rafaelmartins/octokeyz/README.md

# octokeyz

A USB macropad you program with Go.

For documentation please visit: https://octokeyz.rgm.io/

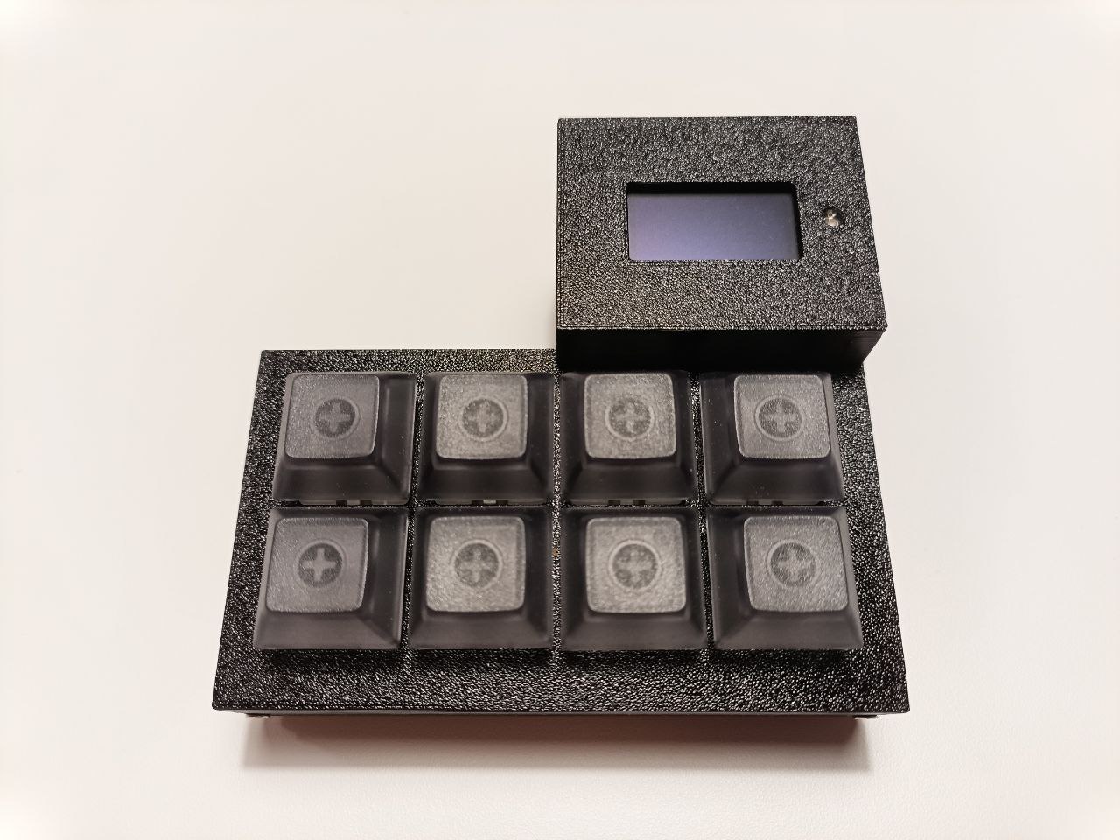
[picture p1: share/images/octokeyz-mega/front.jpg]
octokeyz-mega, assembled
