rafaelmartins/octokeyz/share/images/octokeyz-mega/side.jpg

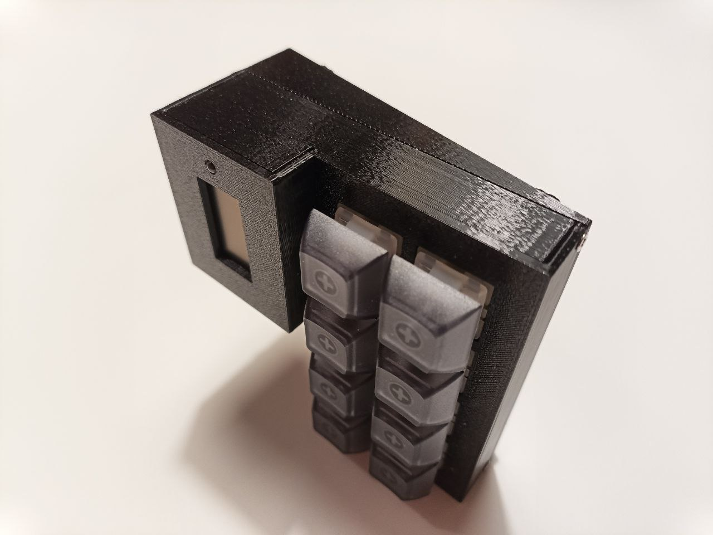
share/images/octokeyz-mega/side.jpg
