rafaelmartins/octokeyz/share/images/octokeyz-mega/top.jpg

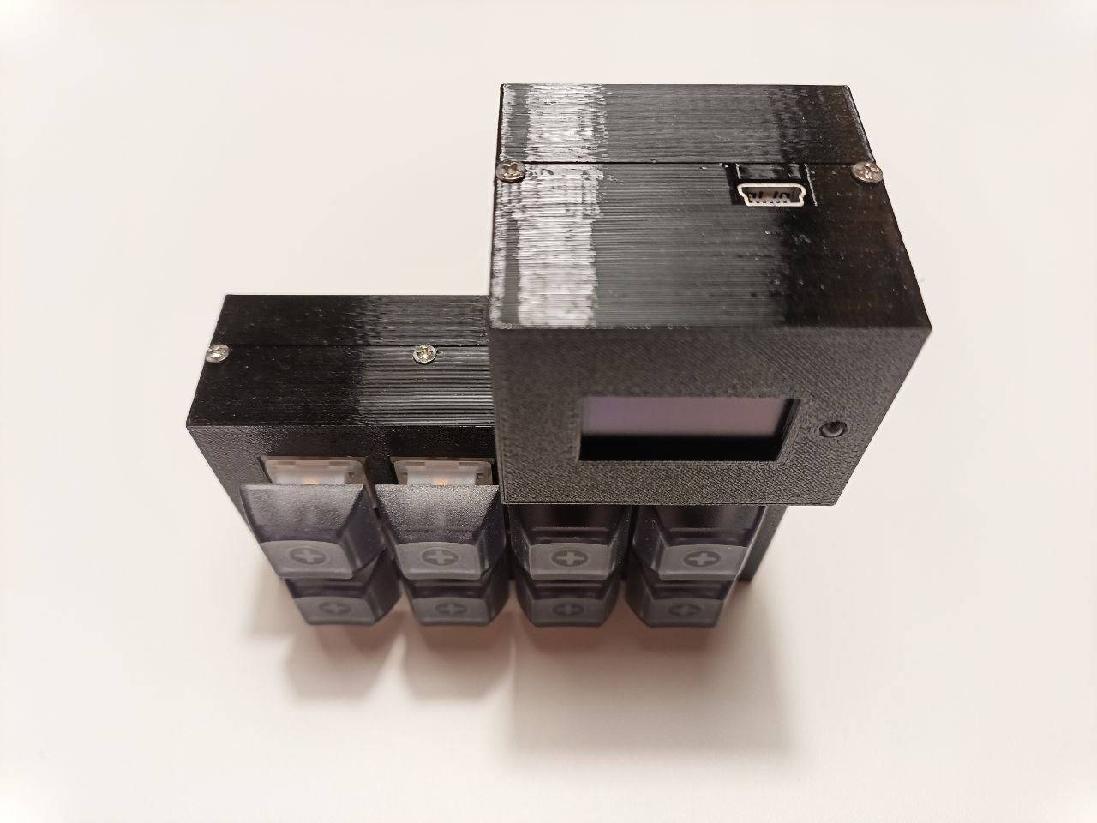
share/images/octokeyz-mega/top.jpg
