rafaelmartins/octokeyz/share/images/octokeyz/top.jpg

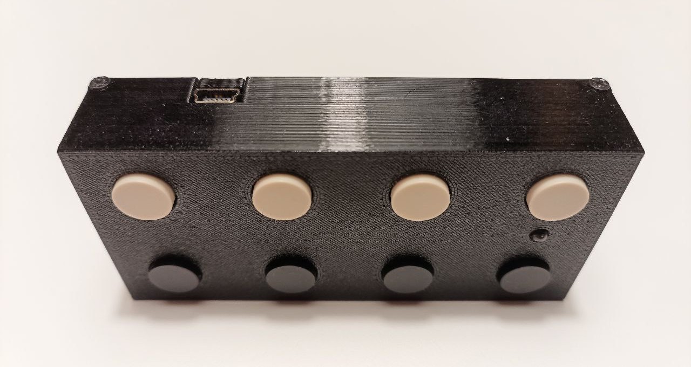
share/images/octokeyz/top.jpg
