rafaelmartins/octokeyz/3d-models/octokeyz-mega/base.stl

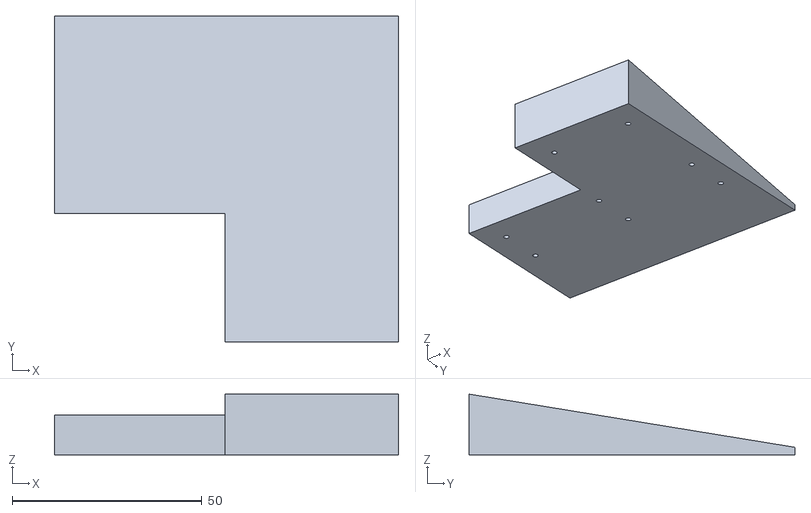
[picture p6: CAD file, 2024-06-15]
3d-models/octokeyz-mega/base.stl
90.6 x 85.8 x 16.0
