rafaelmartins/octokeyz/3d-models/octokeyz/enclosure-back.stl

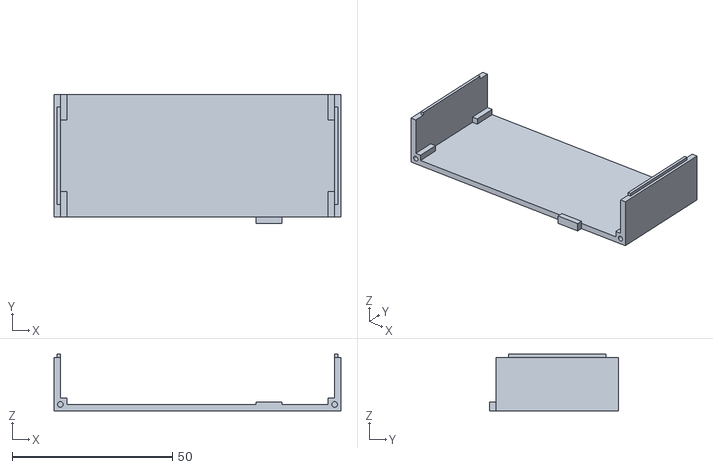
[picture p7: CAD file, 2024-05-31]
3d-models/octokeyz/enclosure-back.stl
89.6 x 40.3 x 17.7
