rafaelmartins/octokeyz/3d-models/octokeyz-mega/enclosure-front-display.stl

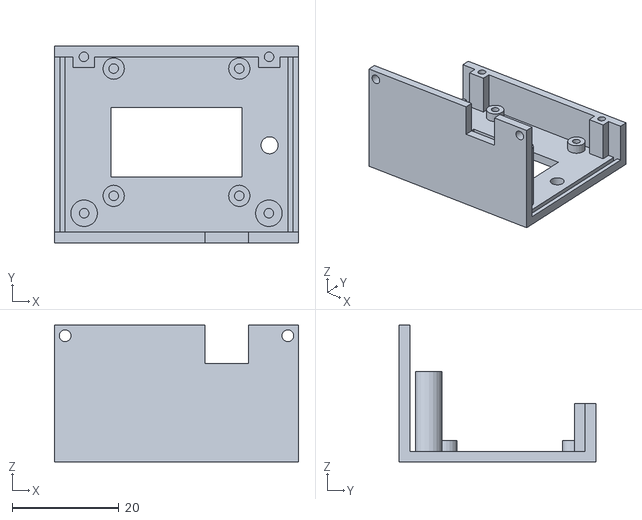
[picture p8: CAD file, 2024-06-15]
3d-models/octokeyz-mega/enclosure-front-display.stl
45.6 x 36.8 x 25.6
