rafaelmartins/octokeyz/3d-models/octokeyz/enclosure-front.stl

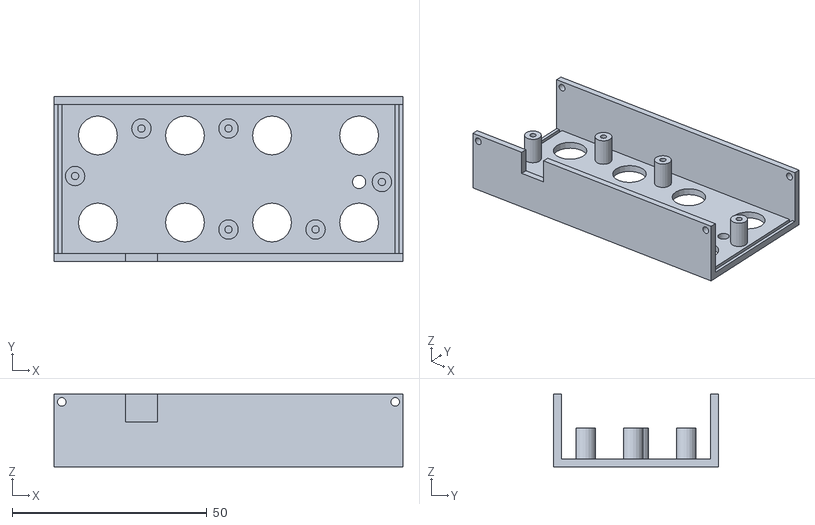
[picture p9: CAD file, 2024-05-31]
3d-models/octokeyz/enclosure-front.stl
89.6 x 42.3 x 18.7
