rafaelmartins/octokeyz/3d-models/octokeyz-mega/enclosure-back.stl

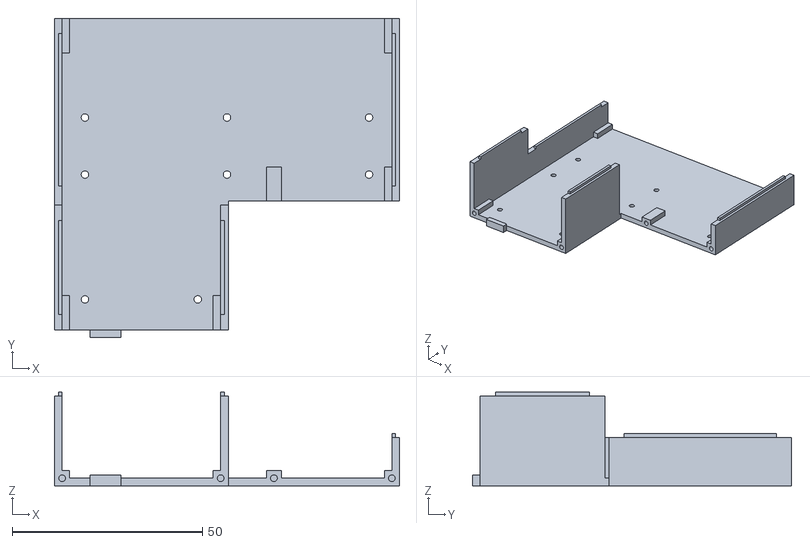
[picture p10: CAD file, 2024-06-15]
3d-models/octokeyz-mega/enclosure-back.stl
90.6 x 83.8 x 24.6
