rafaelmartins/octokeyz/3d-models/octokeyz/led-holder.stl

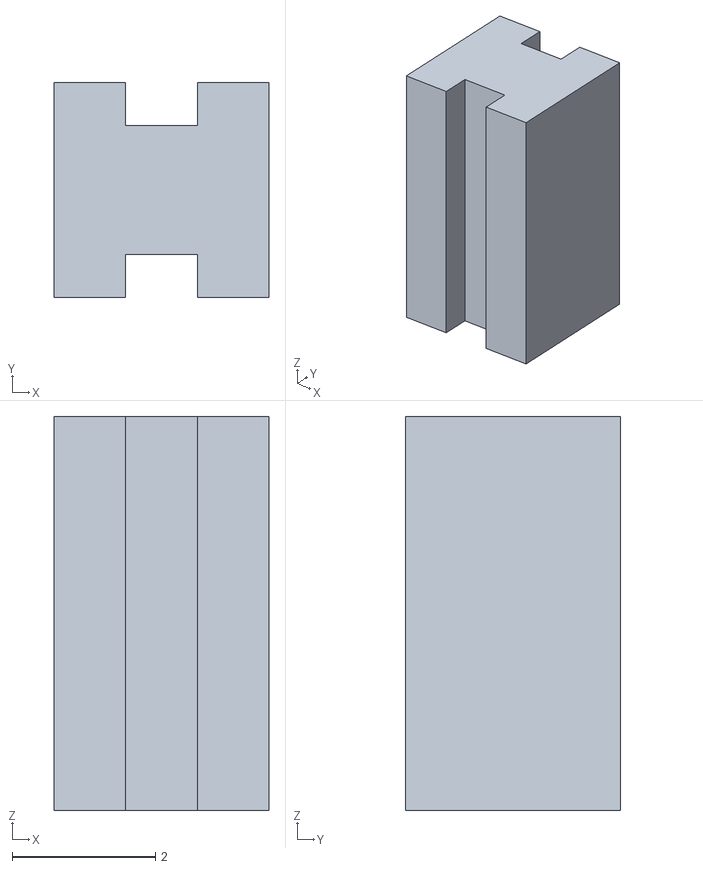
[picture p11: CAD file, 2023-01-06]
3d-models/octokeyz/led-holder.stl
3.00 x 3.00 x 5.50
