rafaelmartins/octokeyz/3d-models/octokeyz-mega/enclosure-front-switches.stl

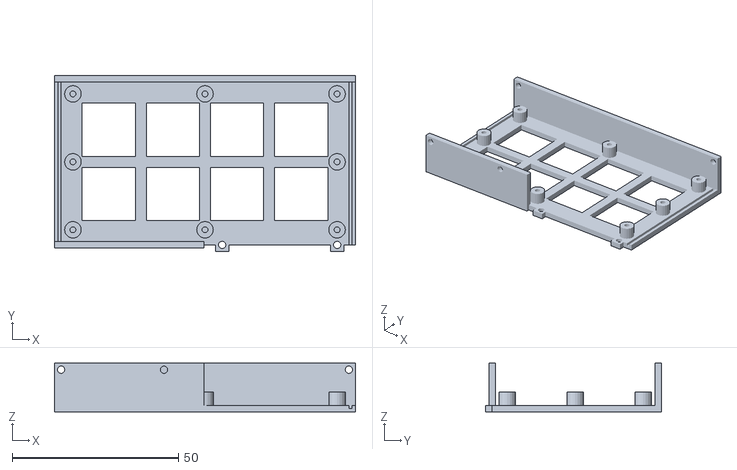
[picture p12: CAD file, 2024-06-15]
3d-models/octokeyz-mega/enclosure-front-switches.stl
90.6 x 53.0 x 14.7
