rafaelmartins/octokeyz/3d-models/octokeyz-mega/led-holder.stl

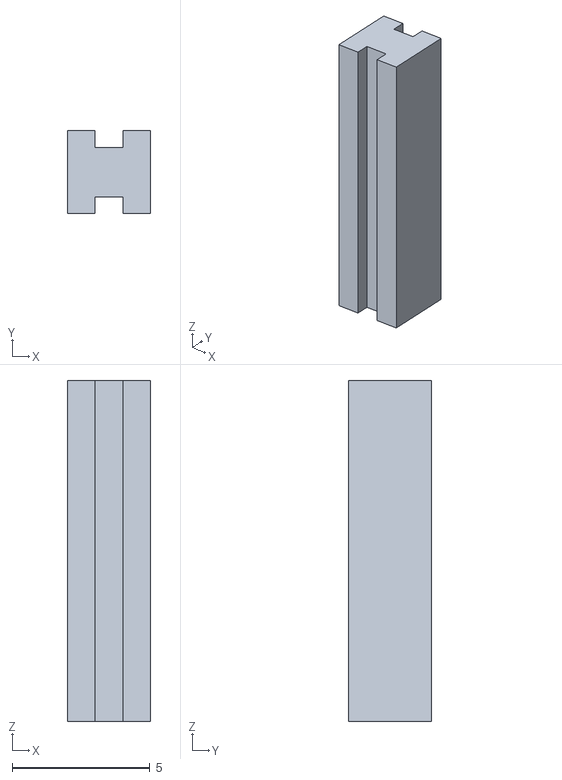
[picture p13: CAD file, 2024-04-14]
3d-models/octokeyz-mega/led-holder.stl
3.00 x 3.00 x 12.4
