rafaelmartins/octokeyz/(list of files, cad)

Other CAD files:
3d-models/octokeyz-mega/led-holder.scad
3d-models/octokeyz/enclosure-back.scad
3d-models/octokeyz/enclosure-front.scad
3d-models/octokeyz/led-holder.scad
