rafaelmartins/octokeyz/pcb/octokeyz-mega/octokeyz-mega.kicad_pcb

## KiCad design pcb/octokeyz-mega/octokeyz-mega.kicad_pcb (2026-02-04)

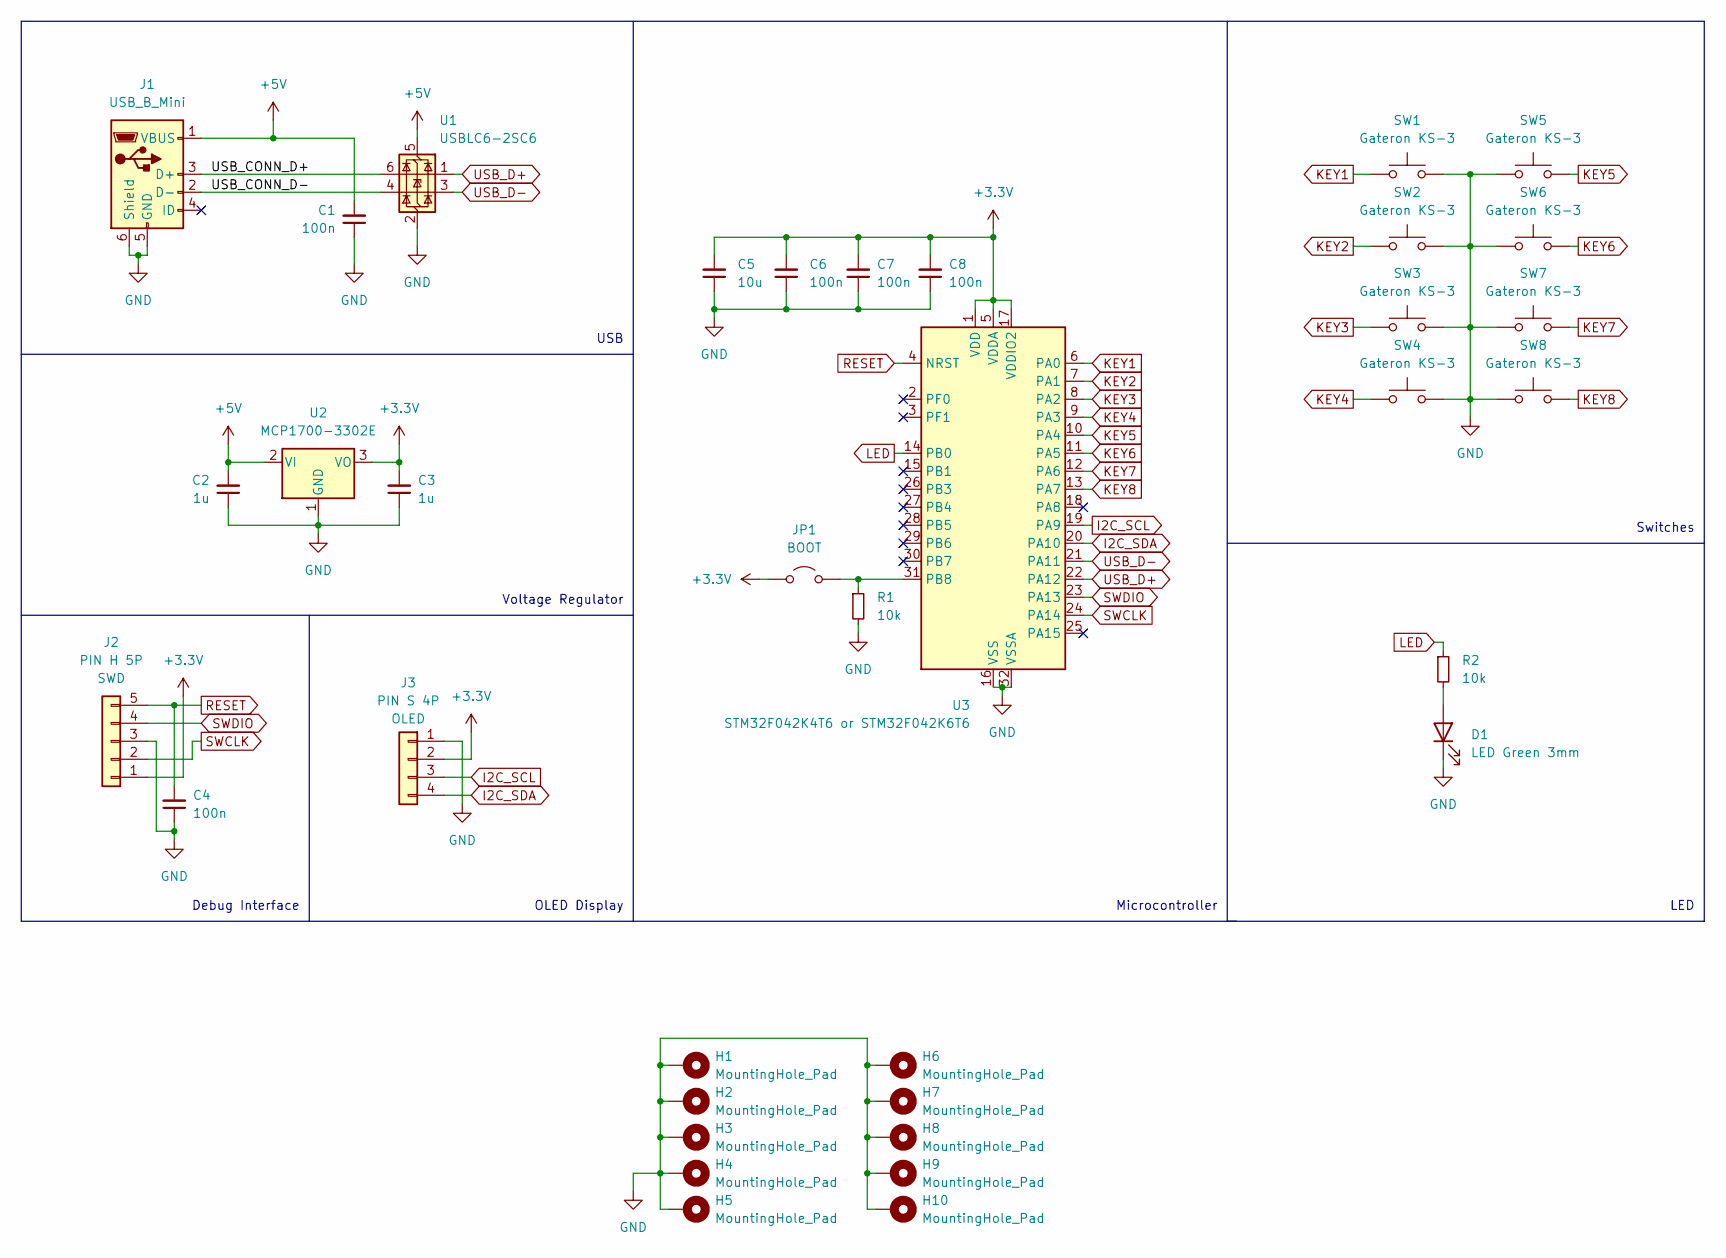
[picture p14: schematic octokeyz-mega.kicad_sch]

Parts:
C1, C4, C6, C7, C8: 100n; C_TDK_FA28; MPN FA28X7R1H104KNU06
C2, C3: 1u; C_TDK_FA28; MPN FA28X7R1E105KRU06
C5: 10u; C_TDK_FA26; MPN FA26X7R1E106KRU06
D1: LED Green 3mm; LED_D3.0mm; MPN OVLBG4C7
H1, H2, H3, H4, H5, H6, H7, H8, H9, H10: MountingHole_Pad; MountingHole_2.2mm_M2_Pad_Via
J1: USB_B_Mini; USB_Mini-B_PTH; MPN GMSB0522132EU
J2: PIN H 5P; PinHeader_1x05_P2.54mm_Horizontal
J3: PIN S 4P; PinSocket_1x04_P2.54mm_Vertical; MPN PPPC041LFBN-RC
JP1: BOOT; PinHeader_1x02_P2.54mm_Horizontal
R1, R2: 10k; R_YAGEO_MFR-25FTE52_Horizontal; MPN MFR-25FTE52-10K
SW1, SW2, SW3, SW4, SW5, SW6, SW7, SW8: Gateron KS-3; SW_Cherry_MX_1.00u_PCB; MPN Gateron KS-3
U1: USBLC6-2SC6; SOT-23-6; MPN USBLC6-2SC6
U2: MCP1700-3302E; TO-92_Inline_Wide; MPN MCP1700-3302E/TO
U3: STM32F042K4T6 or STM32F042K6T6; LQFP-32_7x7mm_P0.8mm; MPN STM32F042K6T6

Connections:
+3.3V: C3.2, C5.2, C6.2, C7.2, C8.2, J2.1, J3.2, JP1.2 (B), U2.3 (VO), U3.1 (VDD), U3.5 (VDDA), U3.17 (VDDIO2)
+5V: C1.2, C2.2, J1.1 (VBUS), U1.5 (VBUS), U2.2 (VI)
/USB_CONN_D+: J1.3 (D+), U1.6 (I/O1)
/USB_CONN_D-: J1.2 (D-), U1.4 (I/O2)
GND: C1.1, C2.1, C3.1, C4.1, C5.1, C6.1, C7.1, C8.1, D1.1 (K), H1.1, H2.1, H3.1, H4.1, H5.1, H6.1, H7.1, H8.1, H9.1, H10.1, J1.5 (GND), J1.6 (Shield), J2.3, J3.1, R1.2, SW1.2, SW2.2, SW3.2, SW4.2, SW5.2, SW6.2, SW7.2, SW8.2, U1.2 (GND), U2.1 (GND), U3.16 (VSS), U3.32 (VSSA)
I2C_SCL: J3.3, U3.19 (PA9)
I2C_SDA: J3.4, U3.20 (PA10)
KEY1: SW1.1, U3.6 (PA0)
KEY2: SW2.1, U3.7 (PA1)
KEY3: SW3.1, U3.8 (PA2)
KEY4: SW4.1, U3.9 (PA3)
KEY5: SW5.1, U3.10 (PA4)
KEY6: SW6.1, U3.11 (PA5)
KEY7: SW7.1, U3.12 (PA6)
KEY8: SW8.1, U3.13 (PA7)
LED: R2.1, U3.14 (PB0)
unnamed: D1.2 (A), R2.2
unnamed: JP1.1 (A), R1.1, U3.31 (PB8)
RESET: C4.2, J2.5, U3.4 (NRST)
SWCLK: J2.2, U3.24 (PA14)
SWDIO: J2.4, U3.23 (PA13)
USB_D+: U1.1 (I/O1), U3.22 (PA12)
USB_D-: U1.3 (I/O2), U3.21 (PA11)

Notes on the sheet:
Switches
OLED Display
Microcontroller
LED
Debug Interface
USB
Voltage Regulator

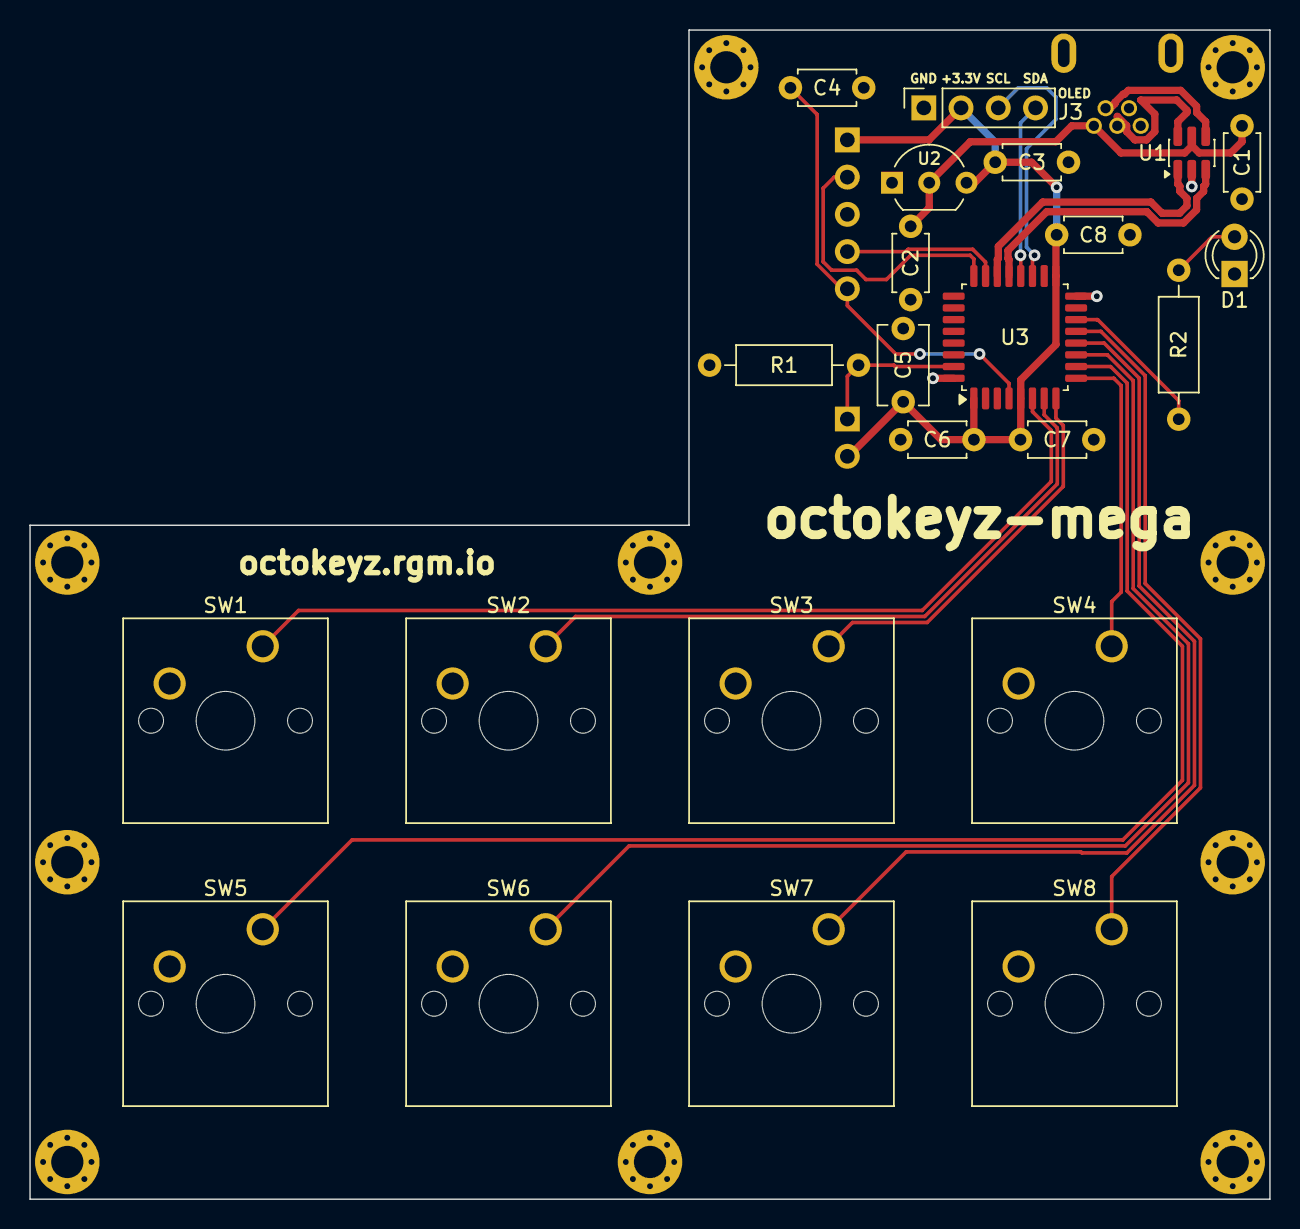
[picture p15: board octokeyz-mega.kicad_pcb from above]

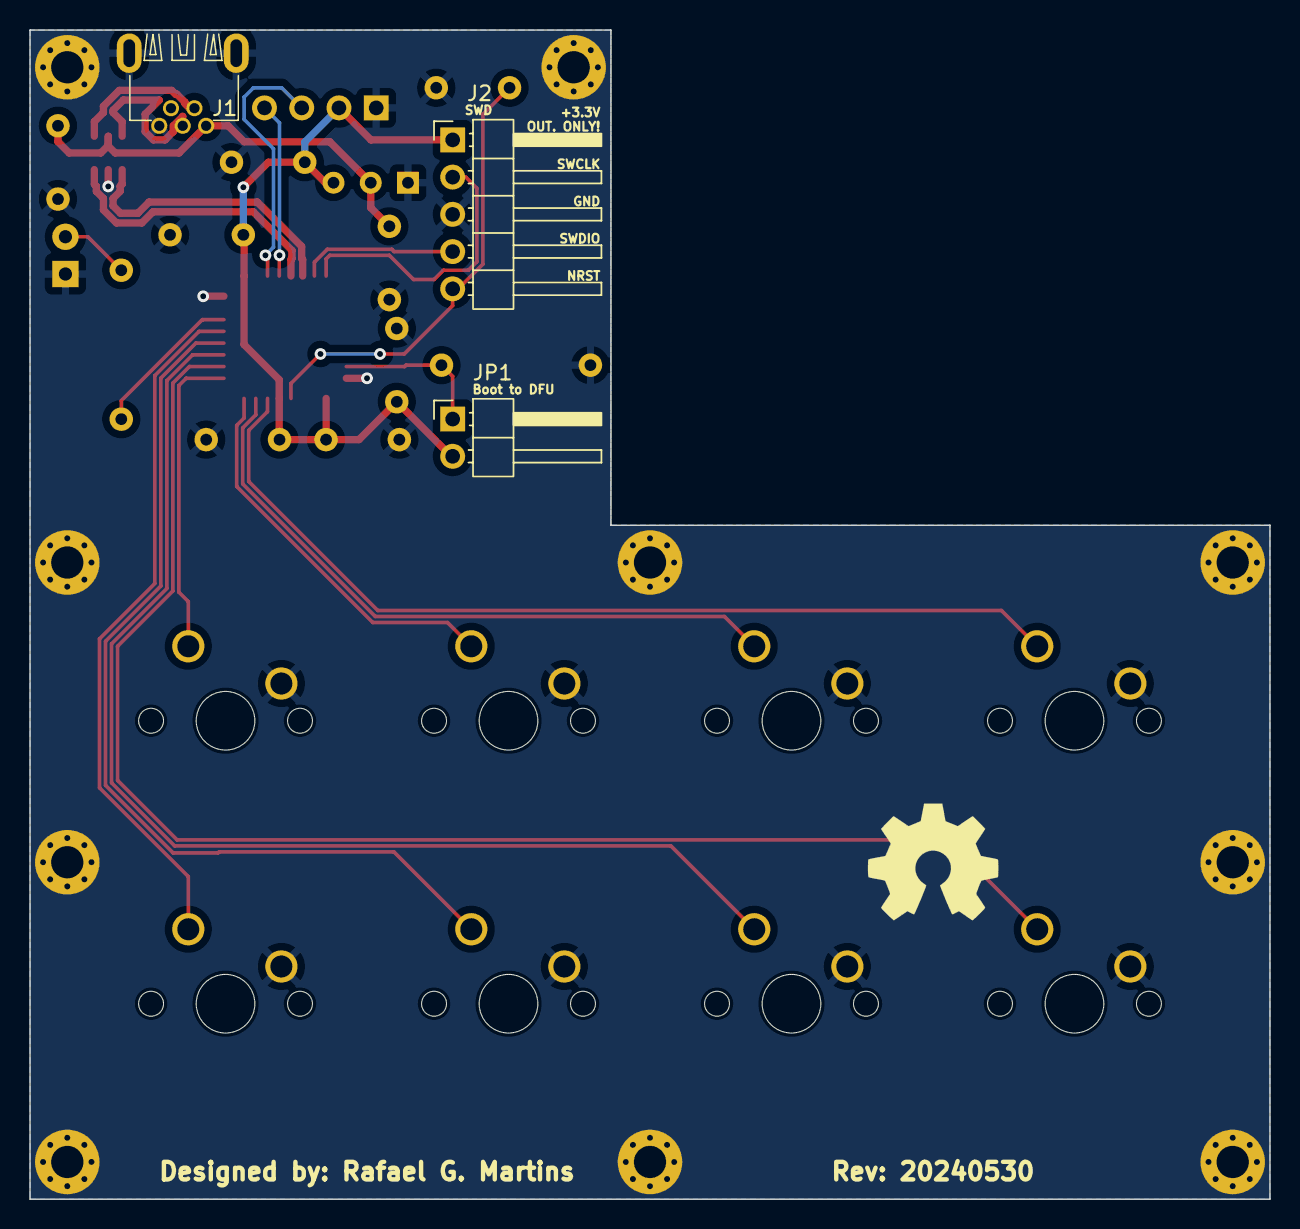
[picture p16: board octokeyz-mega.kicad_pcb from below]

Board: 2 copper layers, 84.6 x 79.8 mm, 36 parts (3 on the bottom side), 23 nets.
