rafaelmartins/octokeyz/pcb/b8.kicad_pcb

## KiCad design pcb/b8.kicad_pcb (2024-04-03)

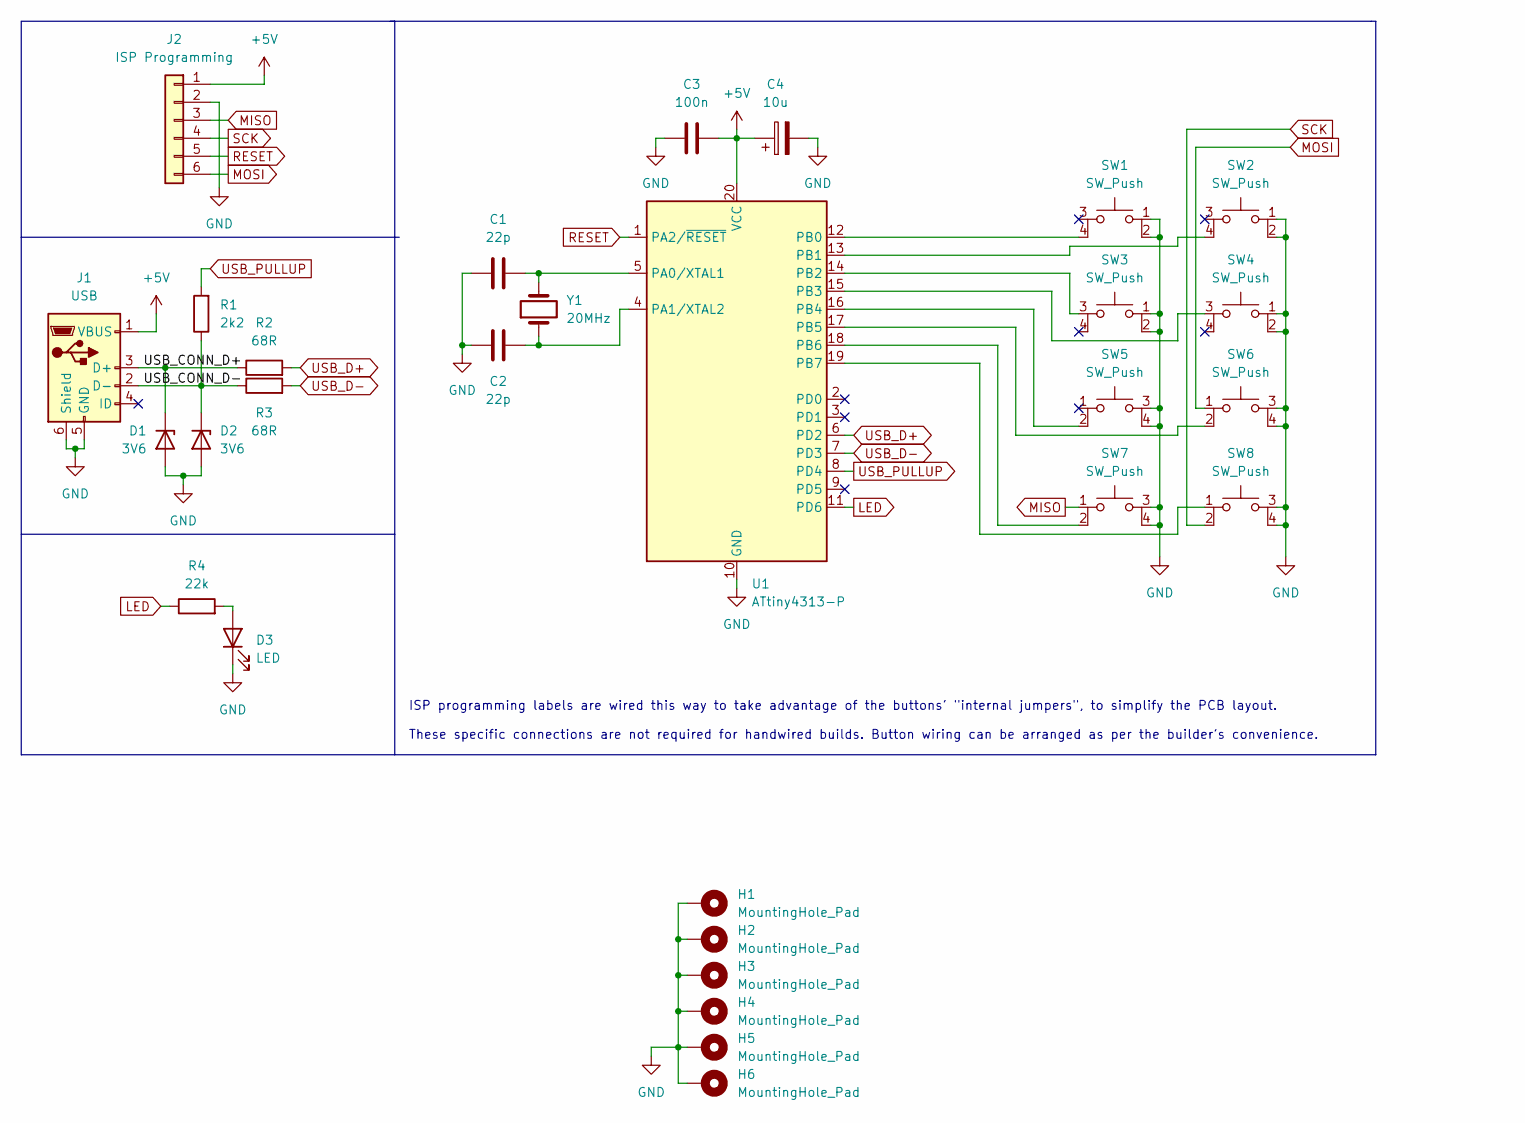
[picture p17: schematic b8.kicad_sch]

Parts:
C1, C2: 22p; C_Disc_D3.0mm_W1.6mm_P2.50mm
C3: 100n; C_Disc_D4.3mm_W1.9mm_P5.00mm
C4: 10u; CP_Radial_D5.0mm_P2.50mm_Horizontal
D1, D2: 3V6; D_DO-35_SOD27_P7.62mm_Horizontal
D3: LED; LED_D3.0mm
H1, H2, H3, H4, H5, H6: MountingHole_Pad; MountingHole_2.2mm_M2_Pad_Via
J1: USB; RND_205-00862
J2: ISP Programming; PinHeader_1x06_P2.54mm_Horizontal
R1: 2k2; R_Axial_DIN0207_L6.3mm_D2.5mm_P10.16mm_Horizontal
R2, R3: 68R; R_Axial_DIN0207_L6.3mm_D2.5mm_P10.16mm_Horizontal
R4: 22k; R_Axial_DIN0207_L6.3mm_D2.5mm_P10.16mm_Horizontal
SW1, SW2, SW3, SW4, SW5, SW6, SW7, SW8: SW_Push; SW_PUSH-12mm
U1: ATtiny4313-P; DIP-20_W7.62mm
Y1: 20MHz; Crystal_HC49-U_Vertical

Connections:
+5V: C3.2, C4.1, J1.1 (VBUS), J2.1, U1.20 (VCC)
/USB_CONN_D+: D1.1 (K), J1.3 (D+), R2.1
/USB_CONN_D-: D2.1 (K), J1.2 (D-), R1.1, R3.1
GND: C1.1, C2.1, C3.1, C4.2, D1.2 (A), D2.2 (A), D3.1 (K), H1.1, H2.1, H3.1, H4.1, H5.1, H6.1, J1.5 (GND), J1.6 (Shield), J2.2, SW1.1, SW1.2, SW2.1, SW2.2, SW3.1, SW3.2, SW4.1, SW4.2, SW5.3, SW5.4, SW6.3, SW6.4, SW7.3, SW7.4, SW8.3, SW8.4, U1.10 (GND)
LED: R4.1, U1.11 (PD6)
MISO: J2.3, SW7.1
MOSI: J2.6, SW6.1
unnamed: D3.2 (A), R4.2
unnamed: C1.2, U1.5 (PA0/XTAL1), Y1.2
unnamed: C2.2, U1.4 (PA1/XTAL2), Y1.1
unnamed: SW1.4, U1.12 (PB0)
unnamed: SW2.4, U1.13 (PB1)
unnamed: SW3.3, U1.14 (PB2)
unnamed: SW4.3, U1.15 (PB3)
unnamed: SW5.2, U1.16 (PB4)
unnamed: SW6.2, U1.17 (PB5)
unnamed: SW7.2, U1.18 (PB6)
unnamed: SW8.1, U1.19 (PB7)
RESET: J2.5, U1.1 (PA2/~RESET)
SCK: J2.4, SW8.2
USB_D+: R2.2, U1.6 (PD2)
USB_D-: R3.2, U1.7 (PD3)
USB_PULLUP: R1.2, U1.8 (PD4)

Notes on the sheet:
ISP programming labels are wired this way to take advantage of the buttons' "internal jumpers", to simplify the PCB layout. These specific connections are not required for handwired builds. Button wiring can be arranged as per the builder's convenience.

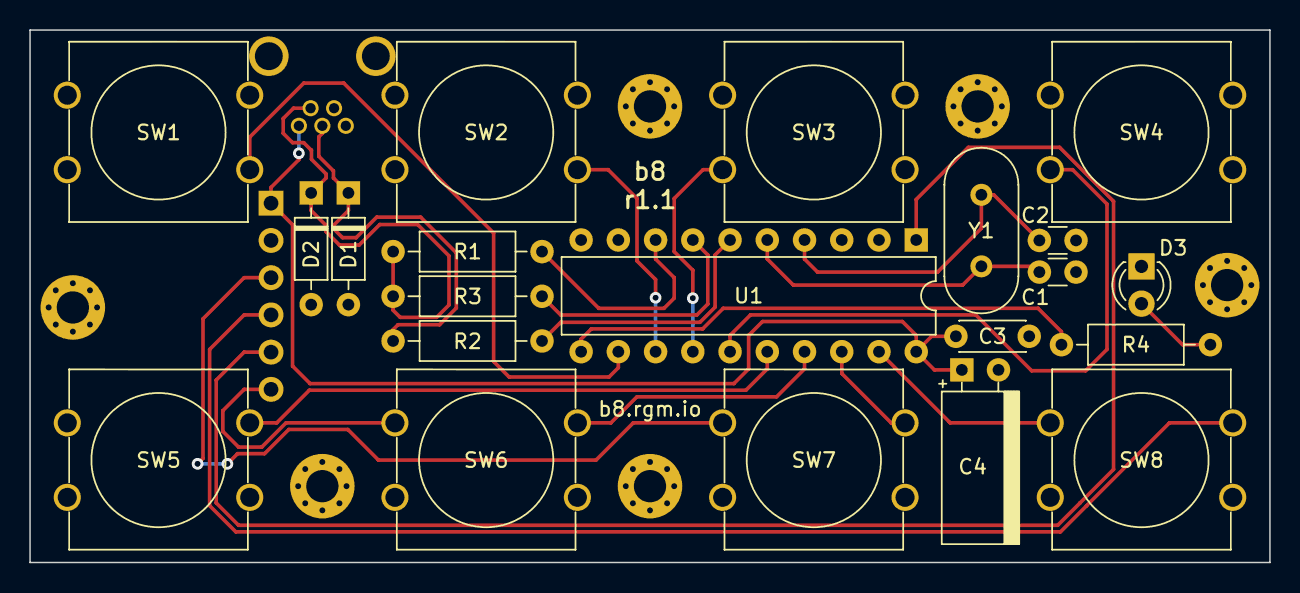
[picture p18: board b8.kicad_pcb from above]

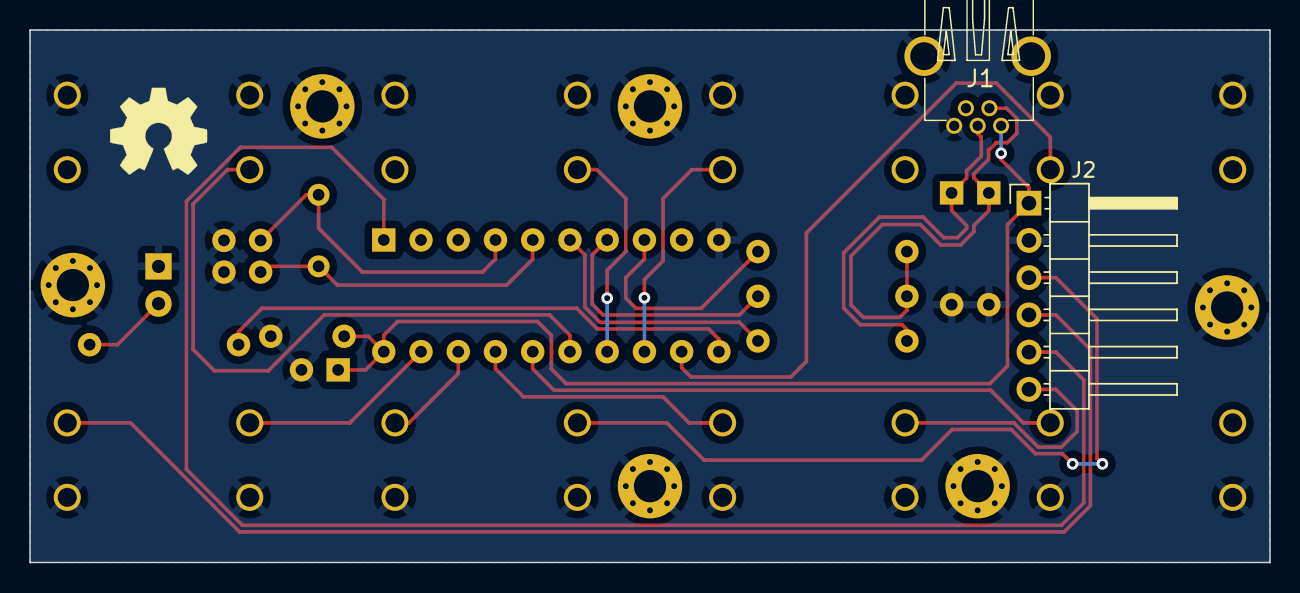
[picture p19: board b8.kicad_pcb from below]

Board: 2 copper layers, 84.6 x 36.3 mm, 29 parts (2 on the bottom side), 23 nets.
