rafaelmartins/octokeyz/firmware/display-font.h

/********************************************************************************
* Copyright (c) 2012, Majenko Technologies
* Copyright (c) 2016, zaltora
* Copyright (c) 2019, 2023-2024, Rafael G. Martins <rafael@rafaelmartins.eng.br>
* All rights reserved.
*
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
* THIS SOFTWARE IS PROVIDED BY THE COPYRIGHT HOLDERS AND CONTRIBUTORS "AS IS" AND
* ANY EXPRESS OR IMPLIED WARRANTIES, INCLUDING, BUT NOT LIMITED TO, THE IMPLIED
* WARRANTIES OF MERCHANTABILITY AND FITNESS FOR A PARTICULAR PURPOSE ARE
* DISCLAIMED. IN NO EVENT SHALL THE COPYRIGHT OWNER OR CONTRIBUTORS BE LIABLE FOR
* ANY DIRECT, INDIRECT, INCIDENTAL, SPECIAL, EXEMPLARY, OR CONSEQUENTIAL DAMAGES
* (INCLUDING, BUT NOT LIMITED TO, PROCUREMENT OF SUBSTITUTE GOODS OR SERVICES;
* LOSS OF USE, DATA, OR PROFITS; OR BUSINESS INTERRUPTION) HOWEVER CAUSED AND
* ON ANY THEORY OF LIABILITY, WHETHER IN CONTRACT, STRICT LIABILITY, OR TORT
* (INCLUDING NEGLIGENCE OR OTHERWISE) ARISING IN ANY WAY OUT OF THE USE OF THIS
* SOFTWARE, EVEN IF ADVISED OF THE POSSIBILITY OF SUCH DAMAGE.
*
* The views and conclusions contained in the software and documentation are those
* of the authors and should not be interpreted as representing official policies,
* either expressed or implied, of the FreeBSD Project.
********************************************************************************/

// this is glcd 5x7 font, modified from the version of it available at:
// https://github.com/SuperHouse/esp-open-rtos/blob/7432c01/extras/fonts/data/font_glcd_5x7.h

#pragma once

#include <stdint.h>

#define display_font_width 5
#define display_font_height 7

static const uint8_t display_font[256][5] = {
    //
    //
    //
    //
    //
    //
    //
    /* \x0 */ {0x00, 0x00, 0x00, 0x00, 0x00},

    //   ###
    //  #####
    //  # # #
    //  #####
    //  ## ##
    //  #   #
    //   ###
    /* \x1 */ {0x3e, 0x5b, 0x4f, 0x5b, 0x3e},

    //   ###
    //  #####
    //  # # #
    //  #####
    //  #   #
    //  ## ##
    //   ###
    /* \x2 */ {0x3e, 0x6b, 0x4f, 0x6b, 0x3e},

    //
    //   # #
    //  #####
    //  #####
    //  #####
    //   ###
    //    #
    /* \x3 */ {0x1c, 0x3e, 0x7c, 0x3e, 0x1c},

    //
    //    #
    //   ###
    //  #####
    //  #####
    //   ###
    //    #
    /* \x4 */ {0x18, 0x3c, 0x7e, 0x3c, 0x18},

    //   ###
    //   # #
    //  #####
    //  # # #
    //  #####
    //    #
    //   ###
    /* \x5 */ {0x1c, 0x57, 0x7d, 0x57, 0x1c},

    //    #
    //   ###
    //  #####
    //  #####
    //  #####
    //    #
    //   ###
    /* \x6 */ {0x1c, 0x5e, 0x7f, 0x5e, 0x1c},

    //
    //
    //    #
    //   ###
    //   ###
    //    #
    //
    /* \x7 */ {0x00, 0x18, 0x3c, 0x18, 0x00},

    //  #####
    //  #####
    //  ## ##
    //  #   #
    //  #   #
    //  ## ##
    //  #####
    /* \x8 */ {0x7f, 0x67, 0x43, 0x67, 0x7f},

    //
    //
    //    #
    //   # #
    //   # #
    //    #
    //
    /* \x9 */ {0x00, 0x18, 0x24, 0x18, 0x00},

    //  #####
    //  #####
    //  ## ##
    //  # # #
    //  # # #
    //  ## ##
    //  #####
    /* \xA */ {0x7f, 0x67, 0x5b, 0x67, 0x7f},

    //
    //    ###
    //     ##
    //   ## #
    //  # #
    //  # #
    //   #
    /* \xB */ {0x30, 0x48, 0x3a, 0x06, 0x0e},

    //   ###
    //  #   #
    //  #   #
    //   ###
    //    #
    //  #####
    //    #
    /* \xC */ {0x26, 0x29, 0x79, 0x29, 0x26},

    //   ####
    //   #  #
    //   ####
    //   #
    //   #
    //   #
    //  ##
    /* \xD */ {0x40, 0x7f, 0x05, 0x05, 0x07},

    //   ####
    //   #  #
    //   ####
    //   #  #
    //   #  #
    //   # ##
    //  ##
    /* \xE */ {0x40, 0x7f, 0x05, 0x25, 0x3f},

    //    #
    //  # # #
    //   ###
    //  ## ##
    //  ## ##
    //   ###
    //  # # #
    /* \xF */ {0x5a, 0x3c, 0x67, 0x3c, 0x5a},

    //  #
    //  ##
    //  ####
    //  #####
    //  ####
    //  ##
    //  #
    /* \x10 */ {0x7f, 0x3e, 0x1c, 0x1c, 0x08},

    //      #
    //     ##
    //   ####
    //  #####
    //   ####
    //     ##
    //      #
    /* \x11 */ {0x08, 0x1c, 0x1c, 0x3e, 0x7f},

    //    #
    //   ###
    //  # # #
    //    #
    //  # # #
    //   ###
    //    #
    /* \x12 */ {0x14, 0x22, 0x7f, 0x22, 0x14},

    //  ## ##
    //  ## ##
    //  ## ##
    //  ## ##
    //  ## ##
    //
    //  ## ##
    /* \x13 */ {0x5f, 0x5f, 0x00, 0x5f, 0x5f},

    //   ####
    //  # # #
    //  # # #
    //   ## #
    //    # #
    //    # #
    //    # #
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
    //
    /* \xFD */ {0x00, 0x3c, 0x3c, 0x3c, 0x3c},

    //
    //
    //
    //
    //
    //
    //
    /* \xFE */ {0x00, 0x00, 0x00, 0x00, 0x00},

    //      #
    //    # #
    //      #
    //    # #
    //
    //   ####
    //      #
    /* \xFF */ {0x00, 0x20, 0x2a, 0x20, 0x6f},
};
