rafaelmartins/octokeyz/(commit log)

2022-10-18 readme: added prototype picture
2022-10-21 pcb: revision 1.0
    [b8.kicad_pcb, b8.kicad_sch]
2022-10-21 3d-models: current models are for my handmade prototype
    [enclosure-back.scad, enclosure-back.stl, enclosure-front.scad, enclosure-front.stl, pcb-spacer.scad, pcb-spacer.stl, settings.scad]
2022-10-21 go: improve button handlers
    this is not 100% safe yet. Event.WaitForRelease may block in a weird
    state if the "button up" event is missed.
2022-10-21 go: ignore "button down" event if some "button up" is queued
    this way it is possible to get out of a Event.WaitForRelease deadlock by
    pressing the button again.
2022-10-26 go: initialize buttons lazily
2022-10-29 firmware: support reading a led state from host
    pcb revision 1.0 adds a led, this patch makes it possible to control it.
    go library does not support it yet.
2022-10-29 go: support writing to led
2022-10-31 3d-models: add 3d-printable models designed for pcb rev 1.0
    [enclosure-back.scad, enclosure-back.stl, enclosure-front.scad, enclosure-front.stl, led-holder.scad, led-holder.stl, settings.scad]
2022-10-31 go: added helper handler to use a button as modifier
2022-11-03 firmware: use "Usage Multi Mode Indicator" selector for led
    this allows the client to request the led to blink or flash without
    having to control that manually.
    golang library not supporting this yet.
    this also improves the led handling and the firmware code in general.
    when turning on the device, the led will stay on until the host sets its
    address.
2022-11-03 go: support led handling features from newer firmware
    this also rewrites the internal usb library to use hidraw instead of
    evdev on linux, and also reduces the report descriptor parsing, to make
    things simpler. we don't need to be generic, as we only support our own
    device.
2022-12-27 firmware: add automatically generated serial number
    the serial number is generated from non-initialized flash memory, which
    is not very reliable, and stored in eeprom. we may change this algorithm
    at some point.
    also, the code that implements this won't fit the attiny2313. devices
    using it won't have serial numbers, and are limited to one unit
    connected per computer.
    [main.c]
2022-12-30 pcb: revision 1.1
    this revision adds a 6th pin to ISP programming header, to allow usage
    of official Microchip probes, like PICKit 4. It also fixes alignment and
    dimensions of the buttons.
    [b8.kicad_pcb, b8.kicad_sch]
2023-01-06 3d-models: adapt 3d models to pcb rev 1.1
    [enclosure-back.stl, enclosure-front.scad, enclosure-front.stl, led-holder.stl, settings.scad]
2023-01-06 firmware: add fuses and lockbits to elf
2023-03-22 go: improve button channel handling
2023-08-17 firmware: go: use usb pid from openmoko
    We still keep some compatibility with the old VID/PID pair. For our
    dedicated pair we won't check manufacturer and product anymore.
    PR: https://github.com/openmoko/openmoko-usb-oui/pull/53
2024-02-24 go: allow custom error handling for button handlers
2024-04-03 pcb: port to kicad 7
    [b8.kicad_pcb, b8.kicad_sch]
2024-04-04 pcb: b8: revision 20240403
    some minor pcb fixes. this also moves the pcb files to pcb/b8, preparing
    to introduce other pcb variants. this also moves the kicad library to
    pcb/lib and adds the missing LICENSE file.
    [b8.kicad_pcb, b8.kicad_sch]
2024-04-04 pcb: b8-mega: revision 20240403
    this is a new pcb variant, that uses mechanical keyboard switches and
    introduces a monochrome oled display. as it uses an STM32 instead of the
    AVR from original b8 pcb, there's no public firmware for it yet.
    [b8-mega.kicad_pcb, b8-mega.kicad_sch]
2024-04-04 3d-models: move original b8 enclosure to b8 folder, remove prototype
    [enclosure-back.scad, enclosure-back.stl, enclosure-front.scad, enclosure-front.stl, led-holder.scad, led-holder.stl, pcb-spacer.scad, pcb-spacer.stl]
2024-04-14 3d-models: b8-mega: new enclosure for the b8-mega variant
    [enclosure-back.scad, enclosure-back.stl, enclosure-front-display.scad, enclosure-front-display.stl, enclosure-front-switches.scad, enclosure-front-switches.stl, enclosure-front.stl, led-holder.scad]
2024-04-14 firmware: b8-mega: initial implementation
    this is a firmware for STM32F042, that works very similar to the
    original b8 firmware, but also includes a display. it does not works
    properly with the current go library, because I discovered a descriptor
    error in the original b8 firmware, that was not yet fixed there.
    [descriptors.c, display-font.h, display.c, display.h, led.c, led.h, main.c]
2024-04-15 firmware: pcb fix usb descriptor mistake.
    this also bumps the device number to 01.01, matching b8-mega
    [main.c]
2024-04-15 firmware: b8-mega: minor fix
    [display.c]
2024-05-11 3d-models: lib: ssd1306: fix screen position
    [enclosure-front-display.stl]
2024-05-11 3d-models: b8-mega: remove unused include
    [enclosure-front-switches.scad, enclosure-front-switches.stl]
2024-05-11 3d-models: b8-mega: added base model
    [base.scad, base.stl, enclosure-back.scad, enclosure-back.stl, enclosure-front-display.stl, enclosure-front-switches.scad, enclosure-front-switches.stl, settings.scad]
2024-05-29 go: added missing LedState type declaration
2024-05-31 *: rebrand project to octokeyz
    This patch also includes an upgrade of the Kicad projects to Kicad 8,
    because they were still based on Kicad 7 and I don't have it installed
    anymore.
    [b8-mega.kicad_pcb, b8-mega.kicad_sch, b8.kicad_pcb, b8.kicad_sch, base.scad, base.stl, enclosure-back.scad, enclosure-back.stl]
2024-05-31 go: stop supporting old shared usb vid/pid
2024-06-01 pcb: octokeyz: revision 20240601
    minor changes.
    [octokeyz.kicad_pcb, octokeyz.kicad_sch]
2024-06-01 pcb: octokeyz-mega: revision 20240601
    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
    [octokeyz-mega.kicad_pcb, octokeyz-mega.kicad_sch]
2024-06-06 firmware: octokeyz-mega: upgrade usbd-fs-stm32
2024-06-09 firmware: octokeyz-mega: reset to bootloader using a key sequence
    [bootloader.c, main.c]
2024-06-09 firmware: octokeyz-mega: minor fix
    [bootloader.c]
2024-06-09 go: clear display and turn led off on close
2024-06-09 firmware: octokeyz-mega: avoid external sw reset to load bootloader
    [bootloader.c, main.c]
2024-06-15 firmware: octokeyz-mega: support boards without a display
2024-06-15 3d-models: octokeyz: support square keycaps
    [enclosure-back.stl, enclosure-front.scad, enclosure-front.stl, settings.scad]
2024-06-15 3d-models: octokeyz-mega: minor fixes
    [base.stl, enclosure-back.stl, enclosure-front-display.stl, enclosure-front-switches.scad, enclosure-front-switches.stl, settings.scad]
2024-06-15 3d-models: octokeyz-mega: add test script
    [test.scad]
2024-06-16 Revert "3d-models: octokeyz: support square keycaps"
    This reverts commit 6c08e28fb599013f4a4b72e768e422f4d81155a3.
    [enclosure-back.stl, enclosure-front.scad, enclosure-front.stl, settings.scad]
2024-06-16 pcb: octokeyz: revision 20240616
    use stm32 instead of avr microcontroller. the prices are similar
    nowadays, and it will allow us to have a single DFU-capable and
    BSD-licensed firmware usable by all boards.
    the board outline and the position of buttons and connectors is the
    same, any existing cases should still fit correctly.
    [octokeyz.kicad_pcb, octokeyz.kicad_sch]
2024-06-23 firmware: fix bootloader issues when building with -O3
    [bootloader.c, main.c]
2024-06-23 pcb: added STM32F042K4T6 as microcontroller alternative
    as this is a purely cosmetic change that doesn't affects the produced
    boards I do not bumped revision number neither re-generated gerber
    files.
    [octokeyz-mega.kicad_pcb, octokeyz-mega.kicad_sch, octokeyz.kicad_pcb, octokeyz.kicad_sch]
2024-06-25 firmware: fix splash screen, limit linker script to 16k flash
    [main.c]
2024-06-25 initial cpack support
    this adds version generation from git, and .bin files. still missing pcb
    interactive bill of materials included in the cpack binary distribution.
2024-06-26 pcb: generate ibom with cmake
2024-07-25 cmake: upgrade cmake-cmsis-stm32
2024-07-29 go: stop listening to hid input events when device is closed
2024-07-29 firmware: upgrade cmake-cmsis-stm32
2024-08-10 firmware: reimplement display driver
    this replaces the backlog implementation with a double buffer implementation,
    and improves the data handling while data is already being sent, avoiding
    dangling content in the screen.
    [display.c, display.h, main.c]
2024-08-18 firmware: display: add a usb out report to clear display with delay.
    the delay is set in milliseconds, limited to 65535ms. this is the maximum
    delay applied when clearing the display: if any write operation happens while
    the delay is ongoing, the display is erased immediately before writing the
    new data. no new data is delayed or lost, making this feature very suitable for
    notifications.
2024-08-18 firmware: led: minor improvements
2024-08-18 build: let cmake-cmsis-stm32 pick its own dfuse-pack script
2024-11-03 share: udev: assign hidraw devices to plugdev group
    TAG+="uaccess" is not enough because systems without a display manager/tty
    won't assign seats to login sessions.
2024-11-11 firmware: upgrade usbd-fs-stm32
2025-03-02 pcb: upgrade to kicad 9
    [octokeyz-mega.kicad_pcb, octokeyz-mega.kicad_sch, octokeyz.kicad_pcb, octokeyz.kicad_sch]
2025-03-02 upgrade usbd-fs-stm32 and cmake-cmsis-stm32
2025-06-02 firmware: fix clock for i2c peripheral
    [display.c]
2025-06-14 firmware: display: wait for display to become available
    SSD1306 displays from some batches will take some time to get ready to accept
    I2C communication, apply some (limited) delay when receiving NACKs for address
    transmissions.
    this also reimplements the automatic detection of display connected to the I2C
    bus.
2025-06-14 firmware: display: restart i2c peripheral on detection timeout
2026-01-21 pcb: octokeyz-mega: fix revision 20240601 -> 20240530
    after almost two years, I was going to assemble a new unit for myself when I realized that
    the revision printed to the board was different from the schematics. since the boards are
    manufactured for very long, its source file contains the same revision and this revision was
    never released before, the easiest fix is to edit the schematics and rename the gerber zip
    file without changing anything on the boards.
    the revision 20240601 never existed :-)
    [octokeyz-mega.kicad_sch]
2026-01-29 pcb: fix some libraries for kicad 9.0.7
    this makes no significant changes to physical layers, no revision changes.
    [octokeyz-mega.kicad_pcb, octokeyz.kicad_pcb, octokeyz.kicad_sch]
2026-02-04 pcb: change soldermask color to blue in physical stackup
    [octokeyz-mega.kicad_pcb, octokeyz.kicad_pcb]
2026-02-21 build: rename actionrafaelmartins/website/{kicad,hardware}
2026-02-22 Revert "build: rename actionrafaelmartins/website/{kicad,hardware}"
    This reverts commit 4f2cdf5d6cc2d84ccabd70681ddec2acb4c06ab4.
2026-02-22 pcb: update asset gen config files
