rafaelmartins/octokeyz/(notices)

Notices in the files:
pcb/octokeyz/octokeyz.kicad_pcb:
Released under CERN Open Hardware Licence Version 2 - Strongly Reciprocal
